hiruna-vidumina/High-Frequency-Amplifier/HF Amplifier-Solidwork Designs/Amp Assembly.SLDASM

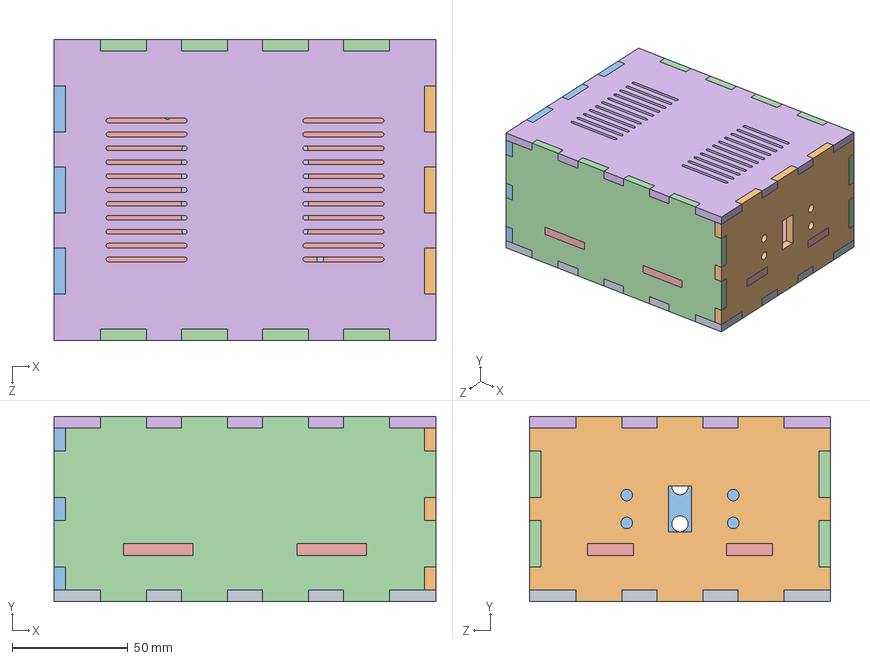
[picture p1: CAD file, 2023-02-19]
HF Amplifier-Solidwork Designs/Amp Assembly.SLDASM
165.0 x 80.0 x 130.0 mm
Bottom
WidthWall_1
WidthWall_2
LengthWall x 2
Stage
Top
