hiruna-vidumina/High-Frequency-Amplifier/HF Amplifier-Solidwork Designs/LengthWall.SLDPRT

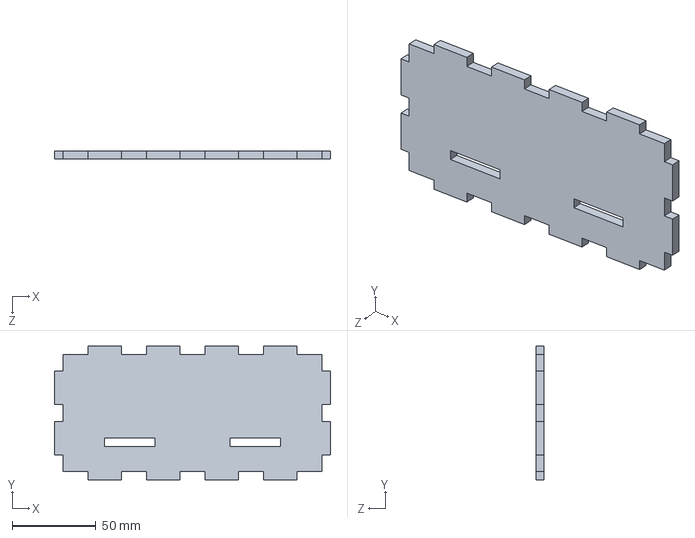
[picture p2: CAD file, 2023-02-19]
HF Amplifier-Solidwork Designs/LengthWall.SLDPRT
165.0 x 80.0 x 5.00 mm
