hiruna-vidumina/High-Frequency-Amplifier/HF Amplifier-Solidwork Designs/WidthWall_1.SLDPRT

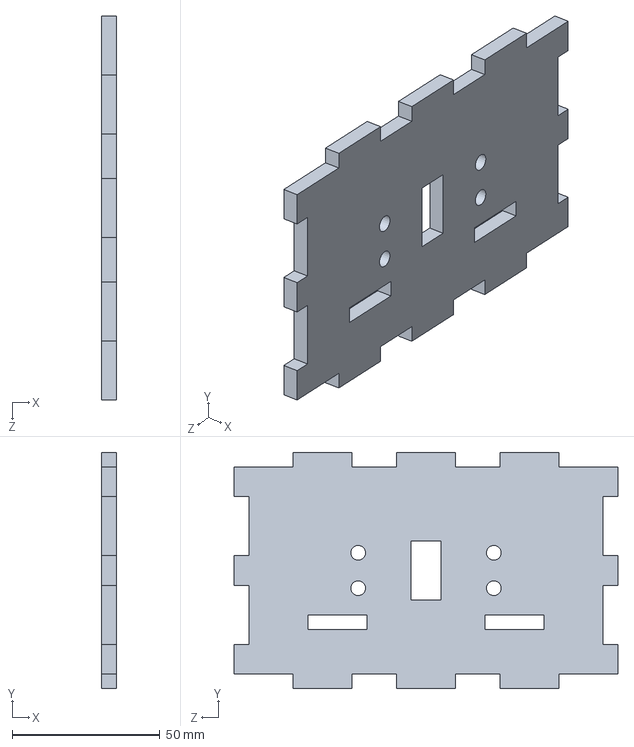
[picture p3: CAD file, 2023-02-19]
HF Amplifier-Solidwork Designs/WidthWall_1.SLDPRT
5.00 x 80.0 x 130.0 mm
