hiruna-vidumina/High-Frequency-Amplifier/HF Amplifier-Solidwork Designs/Stage.SLDPRT

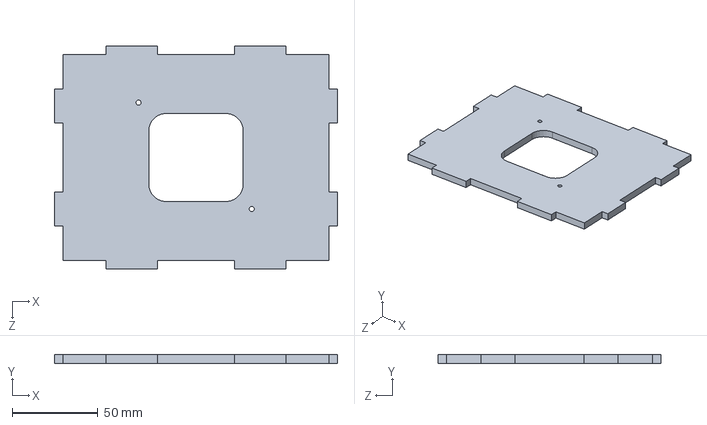
[picture p4: CAD file, 2023-02-19]
HF Amplifier-Solidwork Designs/Stage.SLDPRT
165.0 x 5.00 x 130.0 mm
