hiruna-vidumina/High-Frequency-Amplifier/HF Amplifier-Solidwork Designs/Bottom.SLDPRT

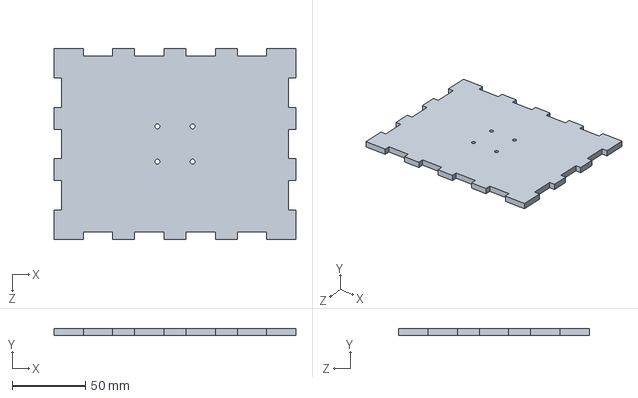
[picture p5: CAD file, 2023-02-19]
HF Amplifier-Solidwork Designs/Bottom.SLDPRT
165.0 x 5.00 x 130.0 mm
