hiruna-vidumina/High-Frequency-Amplifier/HF Amplifier-Solidwork Designs/Top.SLDPRT

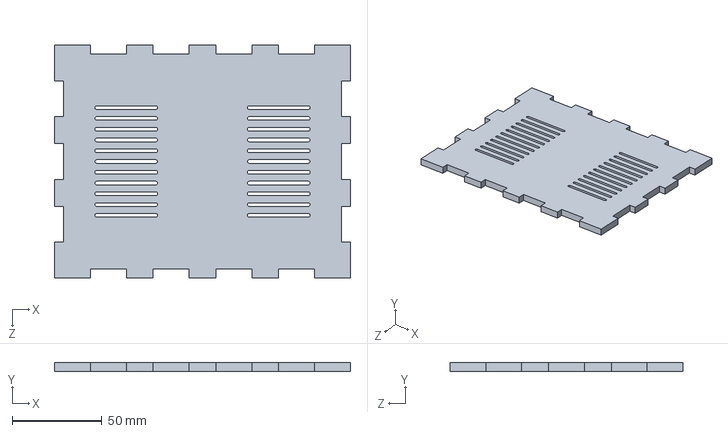
[picture p6: CAD file, 2023-02-19]
HF Amplifier-Solidwork Designs/Top.SLDPRT
165.0 x 5.00 x 130.0 mm
