hiruna-vidumina/High-Frequency-Amplifier/(list of files, cad)

Other CAD files:
HF Amplifier-Solidwork Designs/WidthWall_2.SLDPRT
