hiruna-vidumina/High-Frequency-Amplifier/(list of files, drawings)

Other design files:
combined.ms14
