hiruna-vidumina/High-Frequency-Amplifier/Mid Evaluation.pptx

## High Frequency Amplifier

Group 9

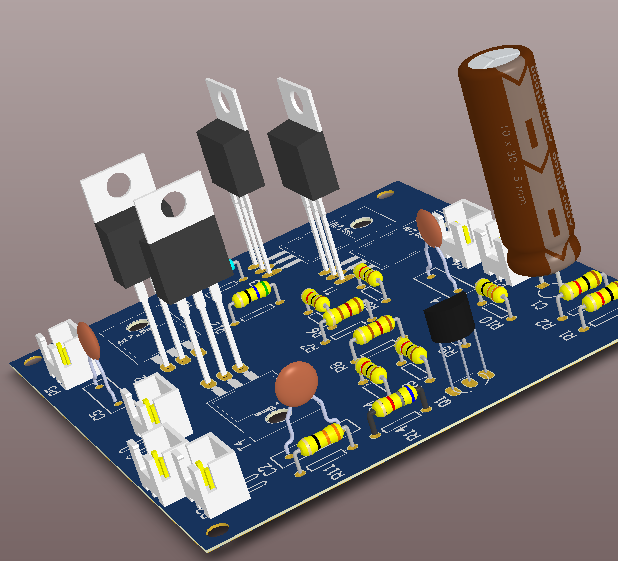
[picture p7: figure]

## Brainstorming Sessions

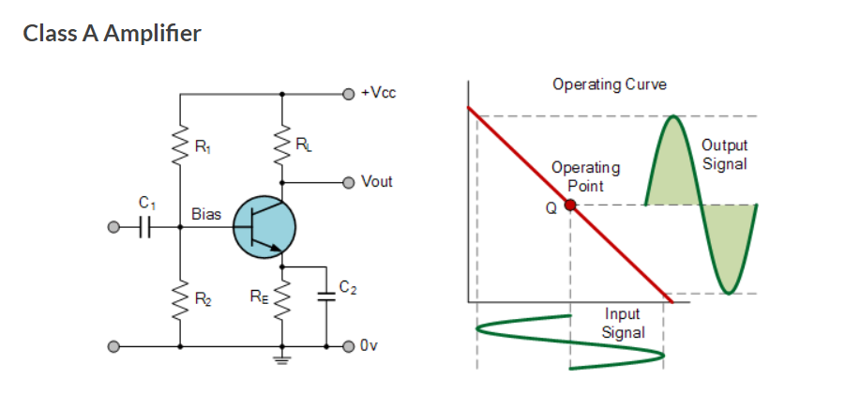
[picture p8: figure]
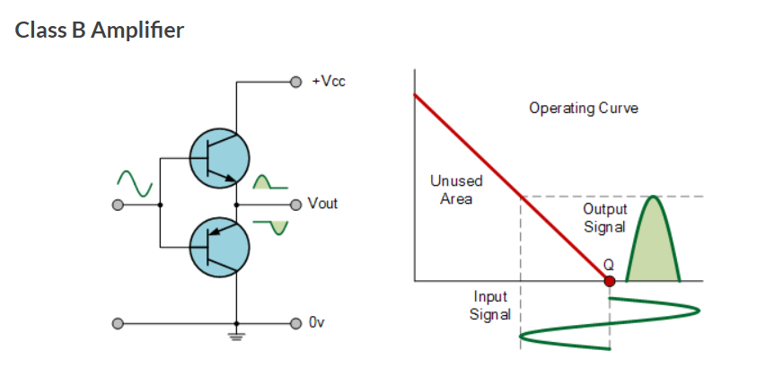
[picture p9: figure]
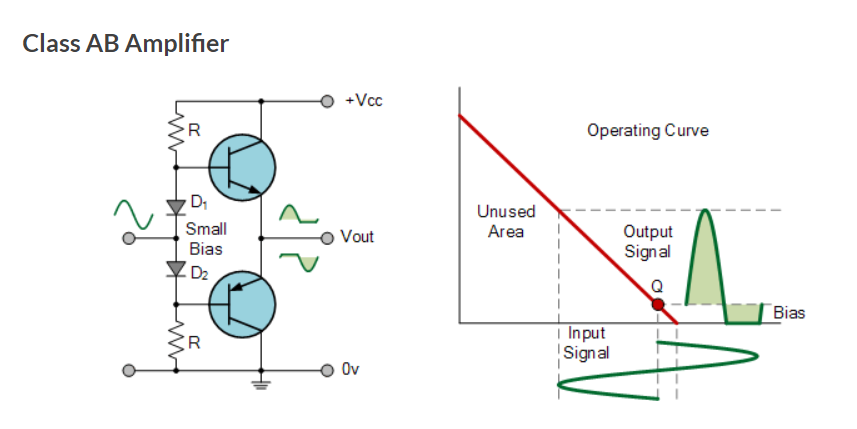
[picture p10: figure]

## Circuit Diagram

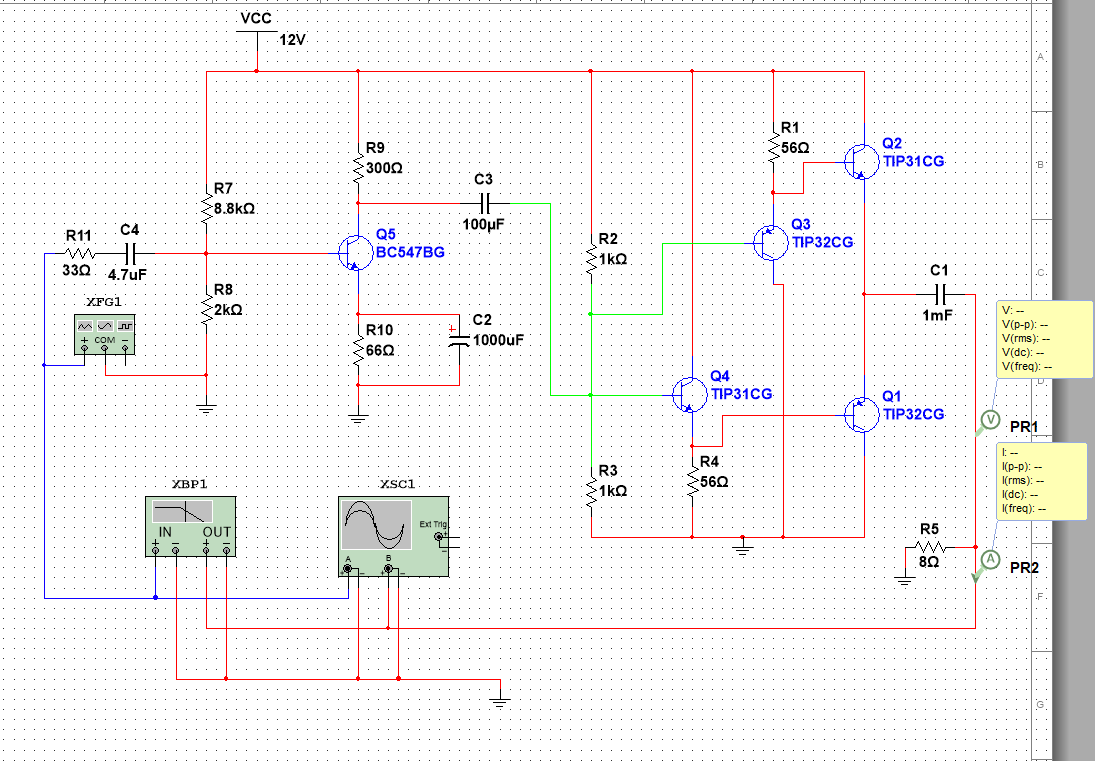
[picture p11: figure]

## Calculations – Stage 1

Capacitor Selection
20 KHz = fmin RE = 66 ohm
XC2 < 1/10 * RE
1/(2πfc) < 1/10 * 66
C > 1.2 * 10⁻⁶ F
∴ C = 1000 μ F

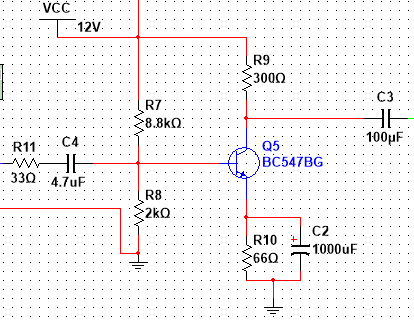
[picture p12: figure]

Resistor Selection
β=245 (Experimental value)
Ic = 20 mA (By observing datasheet)
VCE = 5V (Design Assumption)
Load line :
Ic = - 1/R * VCE + 12/R ( R= RE+RC)
RE+RC ≈ 360
∴ Rc = 300 ohm RE = 66 ohm

## Slide 5

Biasing Resistors Selection
across RE
V=IR
VE -0 = 20mA * 66 ohm
VE = 1.32 V
Since VBE = 0.7 VB = 2.02 V
By Potential dividing rule
2.02 = (R8 / R8 + R7 ) * 12
R7 / R8 = 4.94059
∴ R8 = 2 K ohm R7 = 8.8 K ohm

## AC Analysis

For first stage
rπ = 26∗238/20 β≈238
rπ = 309.4 ohm
(8.8k,2k, rπ are parallel to each other and 33 ohm is series to this parallel combination)
Zin = (8.8K//2K// rπ) + 33 ohm
Zin = 293.03 ohm
Open cct voltage gain
Avo ≈ ( β∗R c)/ Zin
Avo ≈ (238∗300)/293.03 ≈ 243.66

## Stage - 2

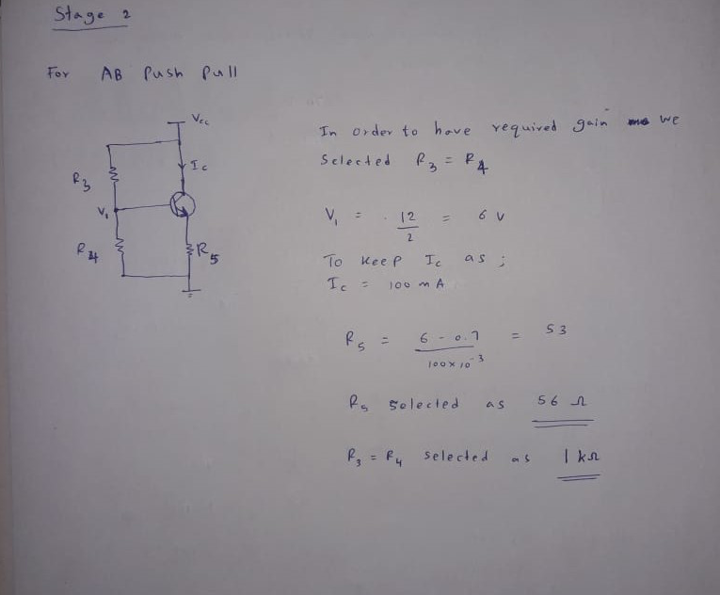
[picture p13: figure]

## Slide 8

RESULTS OBTAINED BY SIMUALTION

Parameter | Conditions | Min | Typ | Max | Unit
Operating Supply Voltage | | | | 12 | V
Input Voltage (pk-pk) | | | | 0.1 | V
Open Circuit Voltage Gain | | | 43.5
Voltage Gain | RL = 8Ω | | 42.5
Power Gain | | | 33.3805 | | dB
Bandwidth | | | 815.11 | | kHz
Power Output | RL = 8Ω | | | 312 | mW
Load Current | RL = 8Ω | | | 197 | mA

## Waveforms Input – Channel A (blue) Output - Channel B (Red)

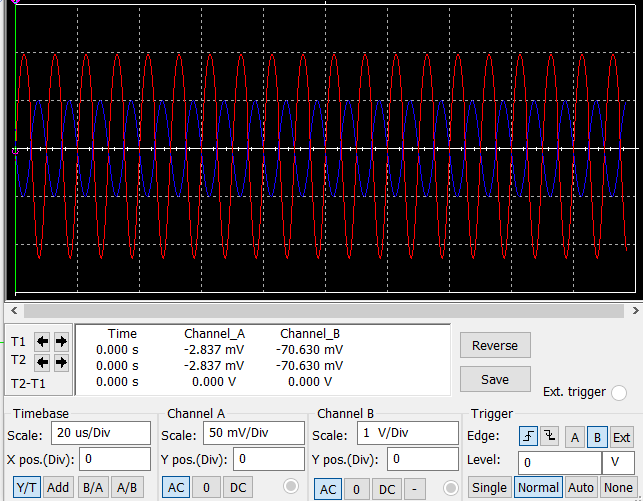
[picture p14: figure]

## Frequency Response

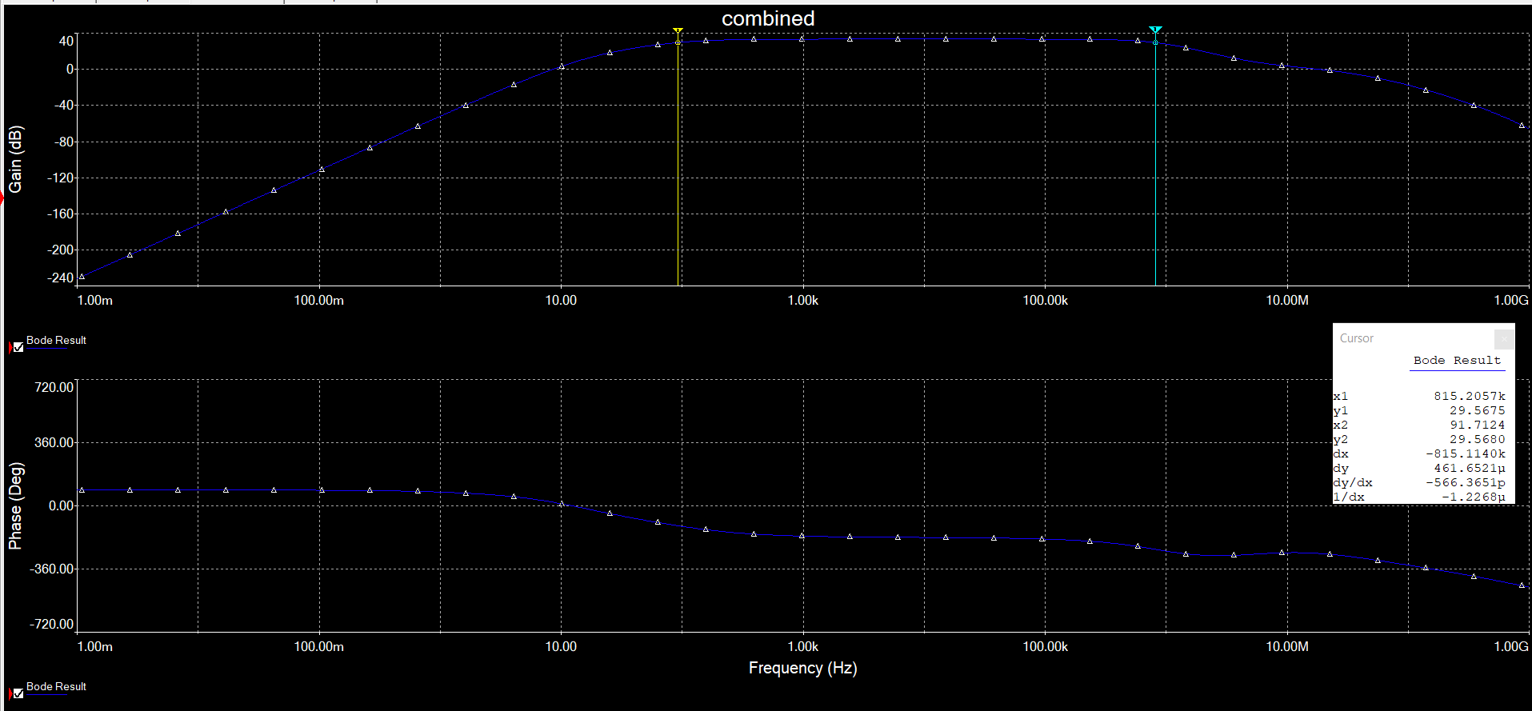
[picture p15: figure]

## Slide 11

Schematic and PCB Layout

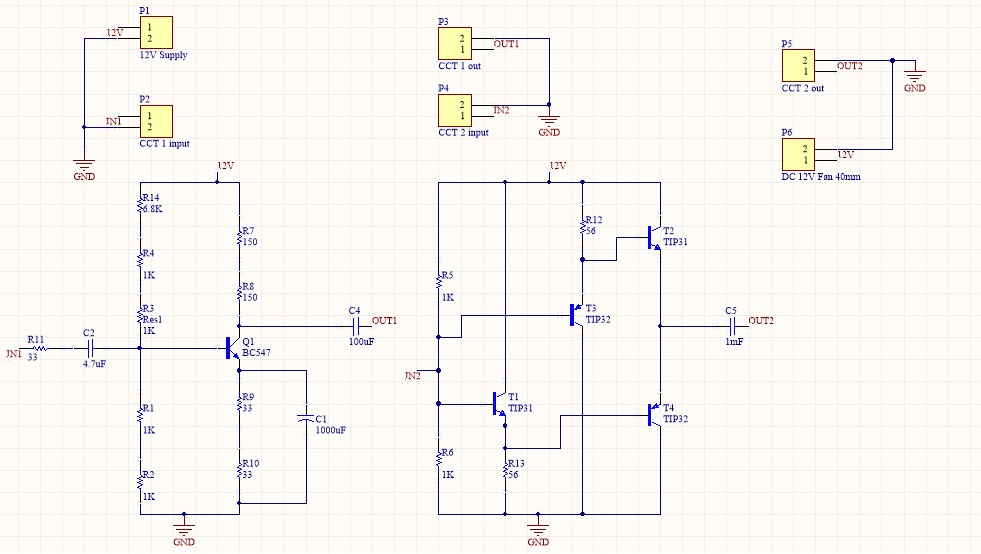
[picture p16: figure]

## Slide 12

Schematic and PCB Layout

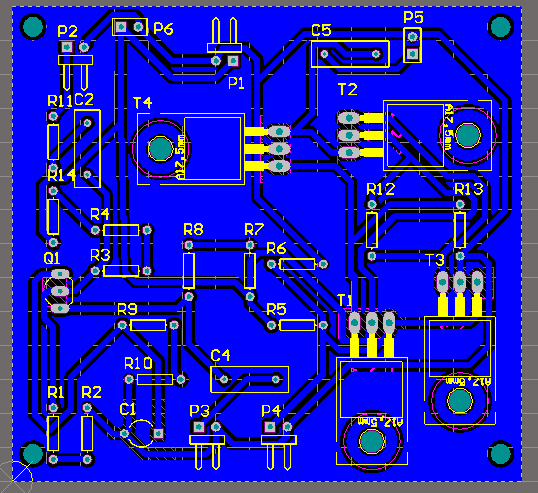
[picture p17: figure]

- Schematic and PCB are designed with Altium 16.
- Additionally, 12V DC fan is used
- Two circuits have separate inputs and outputs.
- 70mm*75mm single layer PCB
- PCB manufacturing method : Laser cutting (Engraving)

## Slide 13

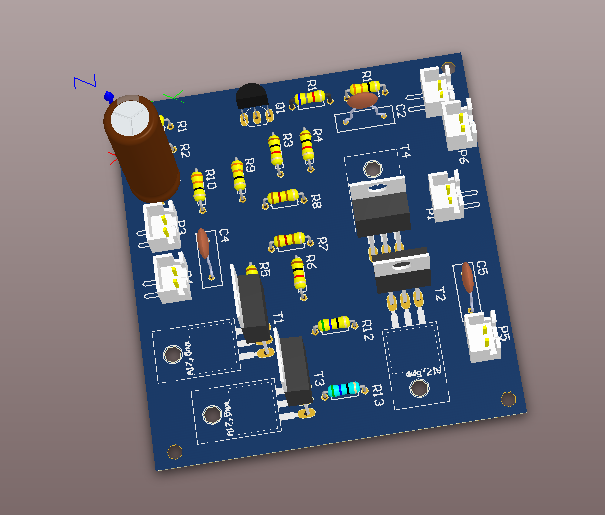
[picture p18: figure]
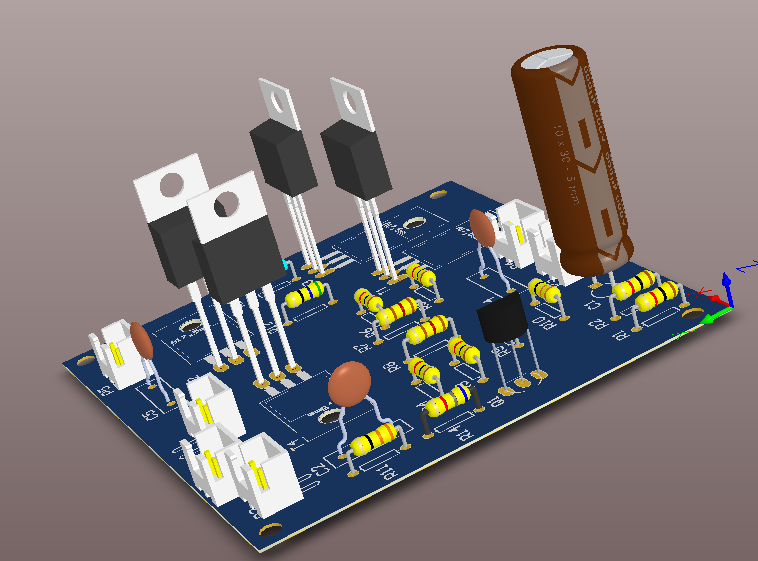
[picture p19: figure]

## ALTERNATIVE METHODS

1. Voltage Biasing
2. Resistor Biasing
3. Diode Biasing

## Slide 15

Voltage Biasing

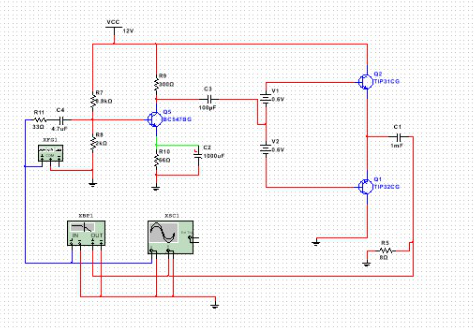
[picture p20: figure]
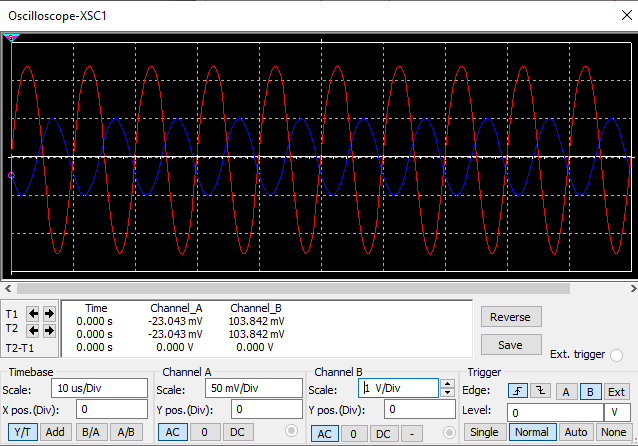
[picture p21: figure]

Drawbacks
- It is not practical to have extra batteries within the amplifiers output stage design

## Slide 16

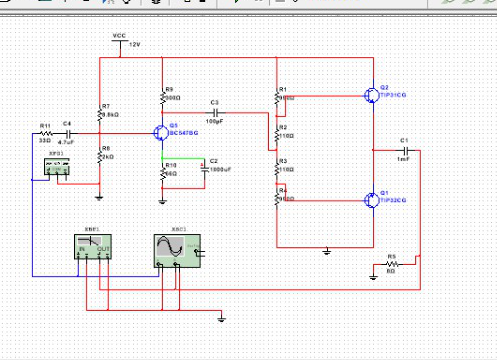
[picture p22: figure]

Drawbacks
- Comparatively the gain is low.
- Finding the exact resistor combination within the voltage divider network is troublesome.(solution: adjustable resistor set)
- Since the biasing resistors’ resistance depend on the operating temperature, small change in the temperature may lead for a change in the quicent collector current.

Resistor Biasing

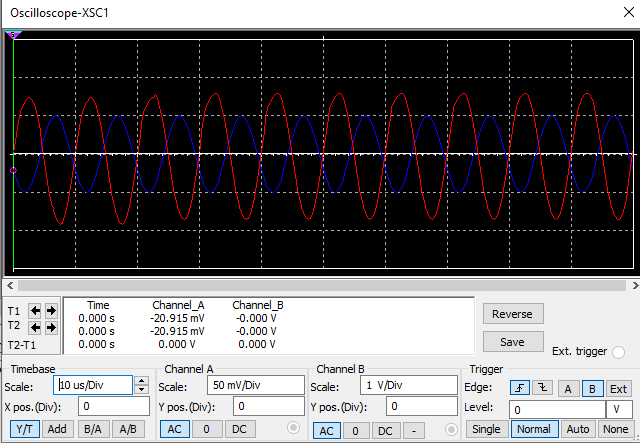
[picture p23: figure]

## Slide 17

Diode Biasing

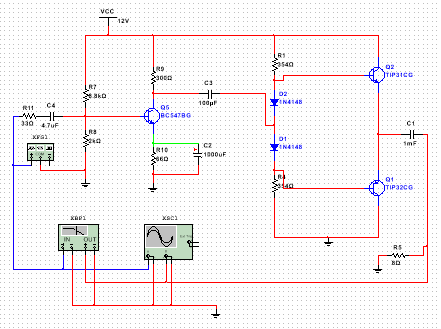
[picture p24: figure]

Drawbacks
- Comparatively the gain is low.
- Cannot be accurate about diode bias being 0.7V.

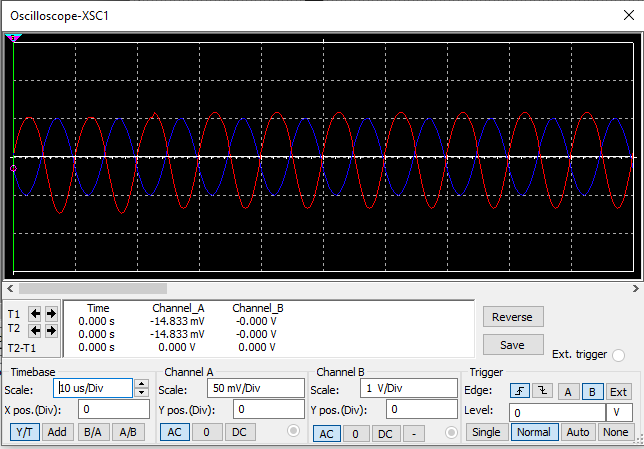
[picture p25: figure]

## Enclosure Design

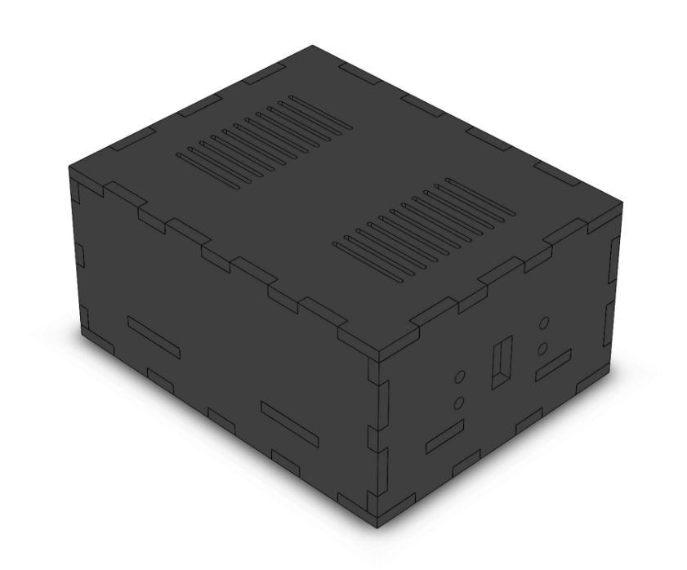
[picture p26: figure]
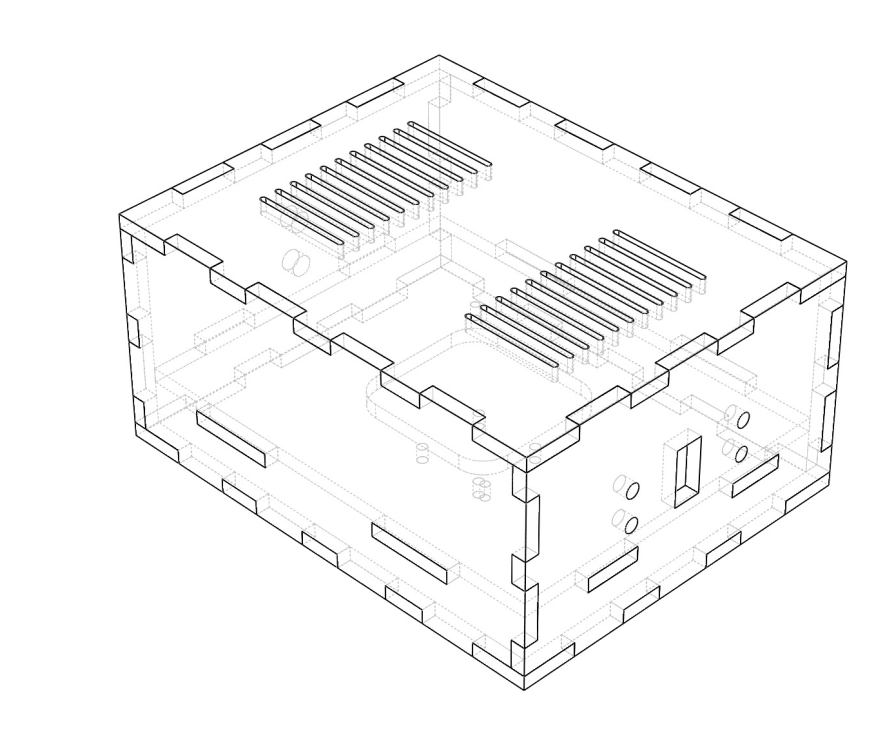
[picture p27: figure]
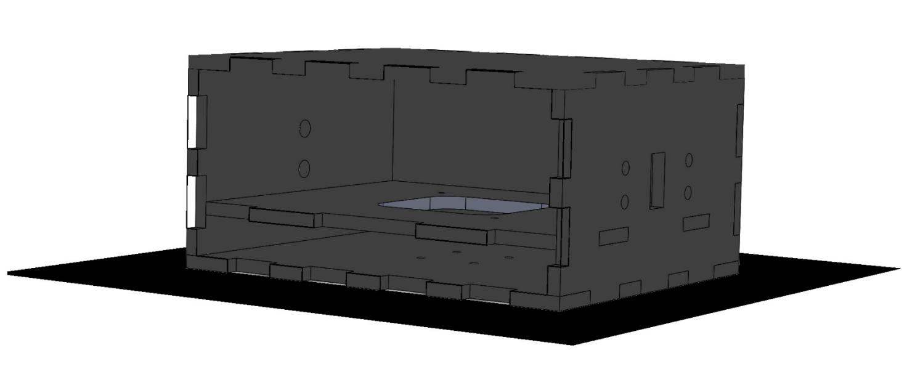
[picture p28: figure]

## Work delegation

Name | Work done
K.N.S.Fernando | Circuit design, calculation
W.A.S.N.Jayawardena | Circuit simulations, calculation
R.G.H.V.Ratnayake | Enclosure design , simulation
G.K.H.Nadeeshan | Schematic & PCB, circuit design
